TheEinfachFelix/PipeWatch/README.md

# PipeWatch

## Sensors

- MSU: LIS3DHTR 
- WS2812B
- Taster (Implementiert)
- Temp: 2x DS18B20(UMW) (Implementiert)
- ADC: ADS1115IDGSR (Implementiert)

## Todos

- Umrechnung der Werte in echte einheiten
- Dashboard für mehrere Geräte
