TheEinfachFelix/PipeWatch/Software/PipeObserver/Readme

Aktuell muss der Außen temperatursensor auf pin 15 gelegt werden und die Neopixel funktionieren nicht

ADC OK
MSU OK
Taster OK
Neopixel Error Unbekannt
temperatursensor Falscher Pin
