TheEinfachFelix/PipeWatch/Hardware/PipeWatch/PipeWatch.kicad_pcb

## KiCad design Hardware/PipeWatch/PipeWatch.kicad_pcb (2025-09-21)

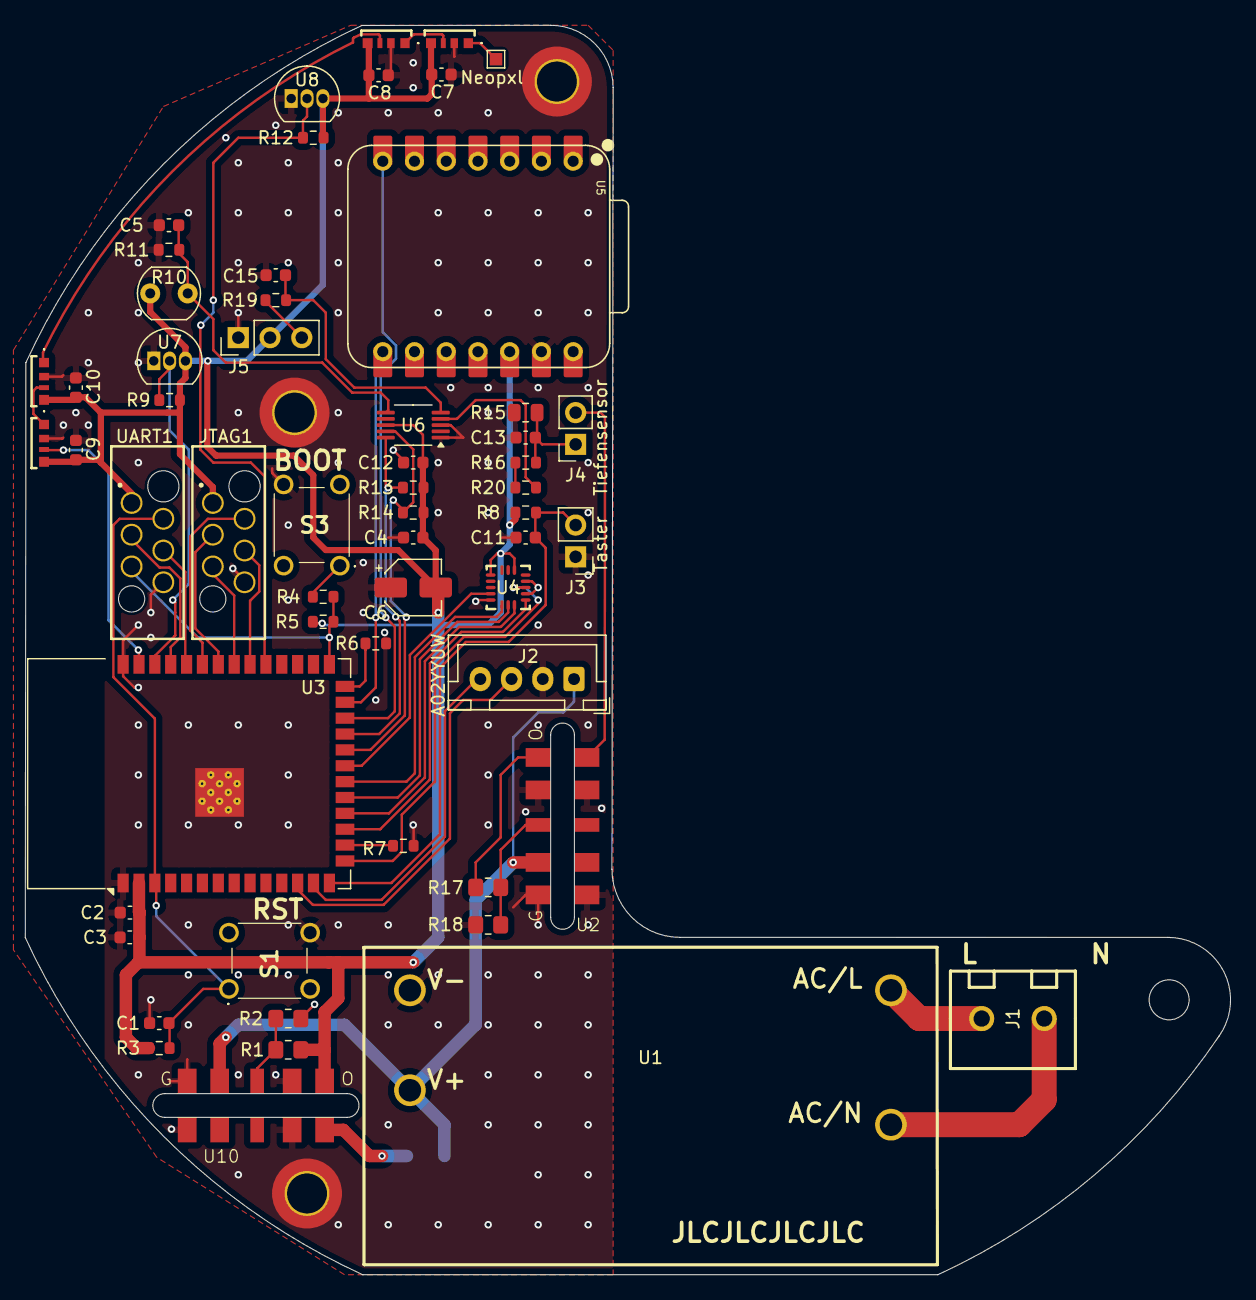
[picture p1: board PipeWatch.kicad_pcb from above]

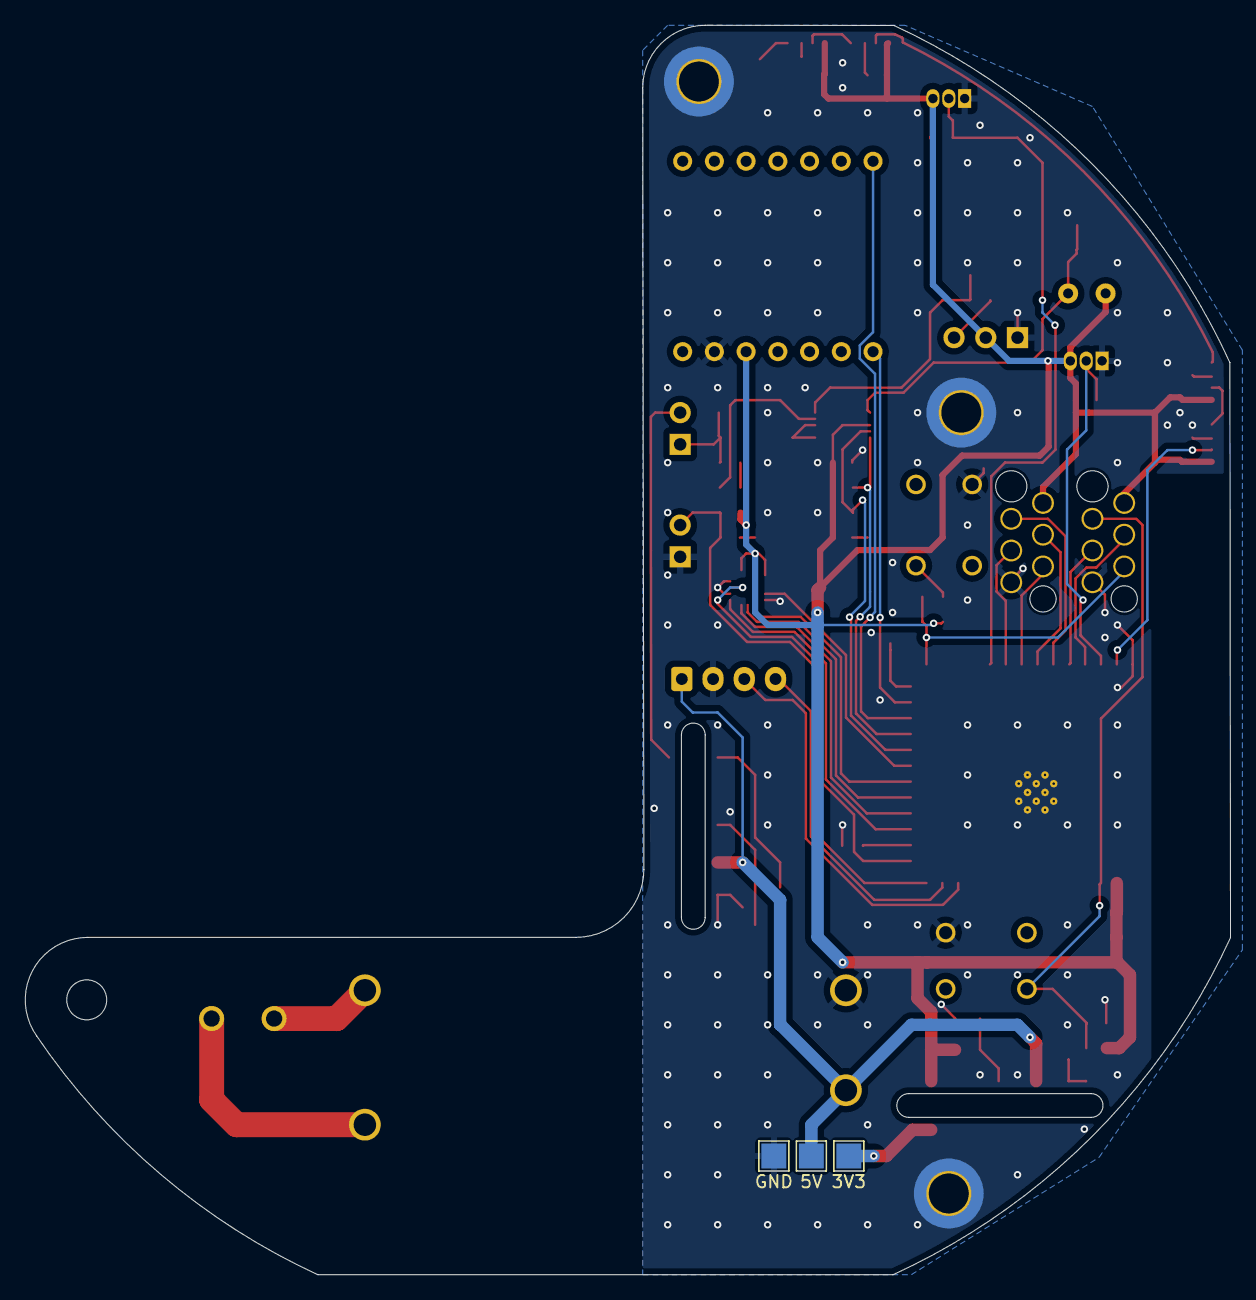
[picture p2: board PipeWatch.kicad_pcb from below]

Board: 2 copper layers, 96.5 x 100.0 mm, 64 parts (3 on the bottom side), 45 nets.

Parts:
C1, C2, C4, C7, C8, C9, C10, C11, C12: 100n; C_0603_1608Metric
C3: 22u; C_0603_1608Metric
C5, C13, C15: 10n; C_0603_1608Metric
C6: 10u; CP_Elec_4x5.8
D1, D2, D3, D4: WS2812B-2020; LED_4691_Neopixel_Edge
H1: MountingHole; MountingHole_3.2mm_M3
H2, H3, H4: MountingHole_Pad; MountingHole_3.2mm_M3_DIN965_Pad_TopBottom
J1: WJ126V-5.0-2P; CONN-TH_WJ126V-5.0-2P
J2: A02YYUW; JST_XH_B4B-XH-A_1x04_P2.50mm_Vertical
J3: Taster; PinHeader_1x02_P2.54mm_Vertical
J4: Tiefensensor; PinSocket_1x02_P2.54mm_Vertical
J5: Roter; PinHeader_1x03_P2.54mm_Vertical
JTAG1: 490107670612
R1, R2, R17, R18: R; R_0805_2012Metric_Pad1.20x1.40mm_HandSolder
R3, R5, R6, R7, R8, R13, R14, R16, R20: 10k; R_0603_1608Metric
R4, R19: 1k; R_0603_1608Metric
R9, R12: 4k7; R_0603_1608Metric
R10: R_Photo; R_LDR_5.0x4.1mm_P3mm_Vertical
R11: 10M; R_0603_1608Metric
R15: 150R; R_0805_2012Metric
S1, S3: TL1105AF160Q
TP1: Neopxl; TestPoint_Pad_1.0x1.0mm
TP2: 3V3; TestPoint_Pad_2.0x2.0mm
TP3: 5V; TestPoint_Pad_2.0x2.0mm
TP5: GND; TestPoint_Pad_2.0x2.0mm
U1: IRM-10-5_C20618064; PWRM-TH_4P-L45.7-W25.4-P8.0
U2, U10: VC-D-40-A
U3: ESP32-S3-WROOM-1-N16R8; ESP32-S3-WROOM-1
U4: LIS3DHTR_C15134; LGA-16_L3.0-W3.0-P0.50-TL
U5: XIAO-ESP32-S3-DIP; XIAO-ESP32S3-DIP
U6: ADS1115IDGS; VSSOP-10_3x3mm_P0.5mm
U7, U8: DS18B20; TO-92_Inline
UART1: 490107670612

Connections:
+3.3V: C2.2, C3.2, C4.2, C6.2, C7.2, C8.2, C9.2, C10.2, C12.2, D1.4 (VDD), D2.4 (VDD), D3.4 (VDD), D4.4 (VDD), J5.2, JTAG1.1, R1.1, R3.2, R5.1, R8.2, R9.1, R10.1, R12.1, R13.2, R14.2, TP2.1, U3.2 (3V3), U4.1 (VDD_IO), U4.14 (VDD), U5.12 (VCC_3V3), U6.8 (VDD), U7.3 (V_{DD}), U8.3 (V_{DD}), U10.4 (Vout), UART1.1
+5V: J2.1, TP3.1, U1.4 (+V), U2.1 (Vin), U10.1 (Vin)
+24V: J4.2, R17.1, U2.4 (Vout)
/ADC/PhotowiederstandInnen/OUT: C5.2, R10.2, R11.1, U6.6 (AIN2)
/ADC/Pressure/OUT: R20.1, U6.4 (AIN0)
/ADC/Roter/OUT: C15.1, R19.1, U6.5 (AIN1)
/ADC_SCL: R13.1, U3.23 (IO21), U6.10 (SCL)
/ADC_SDA: R14.1, U3.22 (IO14), U6.9 (SDA)
/MSU/CS: U3.18 (IO10), U4.8 (CS)
/MSU/INT2: U3.17 (IO9), U4.9 (INT2)
/MSU/SAO: U3.19 (IO11), U4.7 (SDO/SA0)
/MSU/SDI: U3.20 (IO12), U4.6 (SDA/SDI/SDO)
/MSU/SPC: U3.21 (IO13), U4.4 (SCL/SPC)
/MSU_INT1: U3.15 (IO3), U4.11 (INT1)
/TasterCall/OUT: C11.2, J3.2, R8.1, U3.14 (IO20)
/TemperaturOutside/OUT: R12.2, U3.31 (IO38), U8.2 (DQ)
/TemperaturPipe/OUT: R9.2, U3.38 (IO2), U7.2 (DQ)
/Uart2_RX: J2.3, U3.12 (IO8)
/Uart2_TX: J2.4, U3.13 (IO19)
/WS2812B1/Din: D2.3 (DIN), D3.1 (DOUT)
/WS2812B2/Din: D3.3 (DIN), D4.1 (DOUT)
/WS2812B Data: D4.3 (DIN), U3.39 (IO1)
/WS2812B/Din: D1.3 (DIN), D2.1 (DOUT)
/WS2812B/Dout: D1.1 (DOUT), TP1.1
GND: C1.1, C2.1, C3.1, C4.1, C5.1, C6.1, C7.1, C8.1, C9.1, C10.1, C11.1, C12.1, C13.2, C15.2, D1.2 (VSS), D2.2 (VSS), D3.2 (VSS), D4.2 (VSS), H2.1, H3.1, H4.1, J2.2, J3.1, J5.1, JTAG1.6, R2.2, R6.1, R7.1, R11.2, R15.2, R18.2, S1.4 (NO_2), S3.4 (NO_2), TP5.1, U1.3 (-V), U2.2 (GND), U3.1 (GND), U3.40 (GND), U3.41 (GND), U4.5 (GND), U4.10 (RES), U4.12 (GND), U5.13 (GND), U6.1 (ADDR), U6.3 (GND), U7.1 (GND), U8.1 (GND), U10.2 (GND), UART1.6
MTCK: JTAG1.4, U3.32 (IO39)
MTDI: JTAG1.3, U3.34 (IO41)
MTDO: JTAG1.5, U3.33 (IO40)
MTMS: JTAG1.2, U3.35 (IO42)
unnamed: J1.1, U1.1 (AC/N)
unnamed: J1.2, U1.2 (AC/L)
unnamed: C13.1, J4.1, R15.1, R16.2
unnamed: J5.3, R19.2
unnamed: R16.1, R20.2
unnamed: R4.2, S3.1 (COM_1)
unnamed: R17.2, R18.1, U2.3 (FB)
unnamed: R6.2, U3.26 (IO45)
unnamed: R7.2, U3.16 (IO46)
unnamed: U3.24 (IO47), U5.7 (U0TXD/D6/TX)
unnamed: U3.25 (IO48), U5.8 (U0RXD/D7/RX)
unnamed: R1.2, R2.1, U10.3 (FB)
OI0: R4.1, R5.2, U3.27 (IO0), UART1.5
RST: C1.2, R3.1, S1.1 (COM_1), U3.3 (EN), UART1.2
RX0: U3.36 (RXD0), UART1.4
TX0: U3.37 (TXD0), UART1.3
