TheEinfachFelix/PipeWatch/(commit log)

2025-08-31 started the scematic
    [A02YYUW.kicad_sch, PSU.kicad_sch, PipeWatch.kicad_pcb, PipeWatch.kicad_sch, Spannungswandler.kicad_sch]
2025-09-10 tweeked the Layout
    [A02YYUW.kicad_sch, Photowiederstand.kicad_sch, PipeWatch.kicad_pcb, PipeWatch.kicad_sch, Spannungswandler.kicad_sch]
2025-09-11 Started implementing the accelerometer
    [MSU.kicad_sch, PipeWatch.kicad_pcb, PipeWatch.kicad_sch]
2025-09-11 added Binky parts and a load of 3d references
    [MSU.kicad_sch, PipeWatch.kicad_pcb, PipeWatch.kicad_sch, WS2812B.kicad_sch]
2025-09-16 some changes
    [A02YYUW.kicad_sch, MSU.kicad_sch, PipeWatch.kicad_pcb, PipeWatch.kicad_sch, Taster.kicad_sch]
2025-09-17 Added Ten Sensor
    [A02YYUW.kicad_sch, PipeWatch.kicad_pcb, PipeWatch.kicad_sch, Taster.kicad_sch, Temperatur.kicad_sch]
2025-09-18 added adc
    [ADC.kicad_sch, PipeWatch.kicad_pcb, PipeWatch.kicad_sch]
2025-09-20 Started laying traces
    [PipeWatch.kicad_pcb, PipeWatch.kicad_sch, Pressure.kicad_sch, Roter.kicad_sch, StepUP.kicad_sch]
2025-09-21 Final Version (Ordered it)
    [PipeWatch.kicad_pcb, PipeWatch.kicad_sch, StepUP.kicad_sch]
2025-09-24 Changed the scematic page Labeling
    [A02YYUW.kicad_sch, ADC.kicad_sch, MSU.kicad_sch, Photowiederstand.kicad_sch, PipeWatch.kicad_sch, Pressure.kicad_sch, Roter.kicad_sch, Spannungswandler.kicad_sch]
2025-10-08 added temp Sensor
2025-10-08 added adc and conf
2026-02-20 Flows now get imported
2026-02-27 flow can recive data
2026-02-27 added test if adc is running
